bobofet2-1/mc68k-proto-board/README.md

# mc68k-proto-board
Code and design of legacy MC68000 proto board
