bobofet2-1/mc68k-proto-board/docs/design/initial/03-reset-halt.md

Complete MC68000 /HALT & /RESET Circuit — Full Pin Reference

--------------------------------------------------------------------------------------------------------------------------------------------------------------------------------------------------------------------

Component Pinouts Used

DS1813-5 (SOT-23, 3-pin)

   ┌──────┐
 1─┤GND   │
 2─┤VCC   │
 3─┤/RST  │  ← open-drain output
   └──────┘

74HC14 (DIP-14) — using gate 1 only

         ┌────┬────┐
    1A ──┤ 1  │ 14 ├── VCC
    1Y ──┤ 2  │  7 ├── GND
         │    │    │
   (2A ──┤ 3  │ 13 ├── 6A)  ← unused gates
   (2Y ──┤ 4  │ 12 ├── 6Y)
   (3A ──┤ 5  │ 11 ├── 5A)
   (3Y ──┤ 6  │ 10 ├── 5Y)
         └────┴────┘
           (7=GND, 8=4Y, 9=4A)

74HC07 (DIP-14) — using gate 1 only

         ┌────┬────┐
    1A ──┤ 1  │ 14 ├── VCC
    1Y ──┤ 2  │  7 ├── GND   ← open-drain output
         │    │    │
   (2A ──┤ 3  │ 13 ├── 6A)  ← unused gates, leave inputs tied to GND
   (2Y ──┤ 4  │ 12 ├── 6Y)
   (3A ──┤ 5  │ 11 ├── 5A)
   (3Y ──┤ 6  │ 10 ├── 5Y)
         └────┴────┘

MC68000 (DIP-64) — relevant pins only

   Pin 14 → VCC
   Pin 16 → GND
   Pin 17 → /HALT   (bidirectional open-drain)
   Pin 18 → /RESET  (bidirectional open-drain)

--------------------------------------------------------------------------------------------------------------------------------------------------------------------------------------------------------------------

Complete Schematic

 +5V ──────┬──────────────────────────────────────────────────────────────────────┐
           │                                                                       │
           ├──[R1 4.7kΩ]──────────────────────────────────── MC68000 pin 18 /RESET│
           │                                                         │             │
           ├──[R2 4.7kΩ]──────────────────────────────────── MC68000 pin 17 /HALT │
           │                                                         │             │
           │           ╔══ DS1813-5 ══╗                              │             │
           ├──────────►║ pin2  VCC    ║                              │             │
           │           ║              ║                              │             │
          GND ────────►║ pin1  GND    ║                              │             │
                       ║              ║                 RESET BUS    │             │
                       ║ pin3  /RST  ►╠════════════════════╦═════════╝             │
                       ╚══════════════╝                    ║                       │
                                                           ║                       │
           ╔══ 74HC07 ═══════╗                             ║                       │
 +5V ─────►║ pin14  VCC      ║                             ║                       │
 GND ─────►║ pin7   GND      ║                             ║                       │
           ║                 ║                             ║                       │
           ║ pin1   1A  ◄════╬══[see 74HC14 pin2 below]   ║                       │
           ║ pin2   1Y  ►════╬═══════════════════════════►╝                       │
           ║           (open-drain)                                                │
           ║ pin3,5,9,11 unused inputs → GND                                      │
           ╚═════════════════╝                                                     │
                                                                                   │
           ╔══ 74HC14 ═══════╗                                                     │
 +5V ─────►║ pin14  VCC      ║                                                     │
 GND ─────►║ pin7   GND      ║                                                     │
           ║                 ║                                                     │
   node A ►║ pin1   1A       ║                                                     │
           ║ pin2   1Y  ►════╬══► 74HC07 pin1 (1A)                                │
           ║                 ║                                                     │
           ║ pin3,5,9,11 unused inputs → GND                                      │
           ╚═════════════════╝                                                     │
                                                                                   │
           node A                                                                  │
           ┌──────┬──────────────────────────────────────────────────┐            │
           │      │                                                   │            │
      [R4 10kΩ]  [C2 1µF]                                          [SW1]         │
           │      │                                                   │            │
          +5V    GND                                                 GND           │
                                                                                   │
                                                                                   │
 +5V ──[R6 470Ω]──────[LED1 Blue ▶|]────────────────── MC68000 pin 17 /HALT ──────┘
                        anode   cathode

--------------------------------------------------------------------------------------------------------------------------------------------------------------------------------------------------------------------

Connection Summary Table

┌─────────────────────────┬──────────┬────────────────────┬─────┬────────────────────────────────┐
│ From                    │ Pin      │ To                 │ Pin │ Notes                          │
├─────────────────────────┼──────────┼────────────────────┼─────┼────────────────────────────────┤
│ +5V                     │ —        │ DS1813-5 VCC       │ 2   │                                │
├─────────────────────────┼──────────┼────────────────────┼─────┼────────────────────────────────┤
│ GND                     │ —        │ DS1813-5 GND       │ 1   │                                │
├─────────────────────────┼──────────┼────────────────────┼─────┼────────────────────────────────┤
│ DS1813-5 /RST           │ 3        │ RESET BUS          │ —   │ open-drain                     │
├─────────────────────────┼──────────┼────────────────────┼─────┼────────────────────────────────┤
│ +5V                     │ —        │ 74HC14 VCC         │ 14  │ 100nF bypass cap to GND        │
├─────────────────────────┼──────────┼────────────────────┼─────┼────────────────────────────────┤
│ GND                     │ —        │ 74HC14 GND         │ 7   │                                │
├─────────────────────────┼──────────┼────────────────────┼─────┼────────────────────────────────┤
│ Node A                  │ —        │ 74HC14 1A          │ 1   │ RC junction                    │
├─────────────────────────┼──────────┼────────────────────┼─────┼────────────────────────────────┤
│ 74HC14 1Y               │ 2        │ 74HC07 1A          │ 1   │ Schmitt output to buffer input │
├─────────────────────────┼──────────┼────────────────────┼─────┼────────────────────────────────┤
│ +5V                     │ —        │ 74HC07 VCC         │ 14  │ 100nF bypass cap to GND        │
├─────────────────────────┼──────────┼────────────────────┼─────┼────────────────────────────────┤
│ GND                     │ —        │ 74HC07 GND         │ 7   │                                │
├─────────────────────────┼──────────┼────────────────────┼─────┼────────────────────────────────┤
│ 74HC07 1Y               │ 2        │ RESET BUS          │ —   │ open-drain                     │
├─────────────────────────┼──────────┼────────────────────┼─────┼────────────────────────────────┤
│ +5V                     │ —        │ R1 (4.7kΩ) →       │ —   │ to RESET BUS / MC68000 pin 18  │
├─────────────────────────┼──────────┼────────────────────┼─────┼────────────────────────────────┤
│ +5V                     │ —        │ R2 (4.7kΩ) →       │ —   │ to MC68000 pin 17              │
├─────────────────────────┼──────────┼────────────────────┼─────┼────────────────────────────────┤
│ RESET BUS               │ —        │ MC68000 /RESET     │ 18  │ wire-OR                        │
├─────────────────────────┼──────────┼────────────────────┼─────┼────────────────────────────────┤
│ RESET BUS               │ —        │ MC68000 /HALT      │ 17  │ wire-OR                        │
├─────────────────────────┼──────────┼────────────────────┼─────┼────────────────────────────────┤
│ +5V                     │ —        │ R6 (470Ω) → LED1 → │ —   │ to MC68000 pin 17              │
├─────────────────────────┼──────────┼────────────────────┼─────┼────────────────────────────────┤
│ Node A                  │ —        │ R4 (10kΩ)          │ —   │ pull-up to +5V                 │
├─────────────────────────┼──────────┼────────────────────┼─────┼────────────────────────────────┤
│ Node A                  │ —        │ C2 (1µF)           │ —   │ to GND                         │
├─────────────────────────┼──────────┼────────────────────┼─────┼────────────────────────────────┤
│ Node A                  │ —        │ SW1                │ —   │ other end to GND               │
├─────────────────────────┼──────────┼────────────────────┼─────┼────────────────────────────────┤
│ 74HC14/07 unused inputs │ 3,5,9,11 │ GND                │ —   │ prevent floating               │
└─────────────────────────┴──────────┴────────────────────┴─────┴────────────────────────────────┘

--------------------------------------------------------------------------------------------------------------------------------------------------------------------------------------------------------------------

Bypass Capacitors (don't omit these)

┌─────────────────┬───────────────┬────────────────────────────┐
│ Component       │ Cap           │ Placement                  │
├─────────────────┼───────────────┼────────────────────────────┤
│ 74HC14 pin14/7  │ 100nF ceramic │ as close as possible to IC │
├─────────────────┼───────────────┼────────────────────────────┤
│ 74HC07 pin14/7  │ 100nF ceramic │ as close as possible to IC │
├─────────────────┼───────────────┼────────────────────────────┤
│ DS1813-5 pin2/1 │ 100nF ceramic │ across VCC/GND             │
└─────────────────┴───────────────┴────────────────────────────┘
