bobofet2-1/mc68k-proto-board/docs/design/initial/04-reset-halt.md

MC68000 /HALT \& /RESET Circuit — Complete With Pin Numbers

\---

ASCII Schematic

&#x20;                                                                    MC68000

+5V ──┬──\[R3 10kΩ]──────┬──────────────────────────────────────────────────
│                  │
│            DS1813-5                           74HC07 (DIP-14)
│            ┌─────┴──┐                        ┌──────────────────┐
├──────────► │2  VCC  │              ┌─────────┤1(1A)    (1Y)2├───────────┐
│            │        │              │    ┌────┤3(2A)    (2Y)4├────────┐  │
GND ────────► │1  GND  │              │    │    │                  │    │  │
│        │              │    │    │  +5V ──────────► │14  │  │
│3  /RST ├──────────────┘    │    │  GND ──────────► │7   │  │
└────────┘  (open-drain)      │    │                  │    │  │
│    │    ┌─────────────┤5(3A) │  │
│    │    │    ┌────────┤9(4A) │  │
│    │    │    │        │         │  │
│    │    │    │    (3Y)6├───────────┤
│    │    │    │    (4Y)8├────────┤  │
│    │    │    │         │        │  │
│    │    │    │  unused:│        │  │
│    │    │    │  11,13 ─► GND    │  │
│    │    │    │         └─────────┘  │
│    │    │    │                      │
74HC14 (DIP-14)                            │    │    │    │                      │
┌───────────────┐                          │    │    │    │                      │
│               │                          │    │    │    │                      │
│ (1A)1 ◄── NODE\_A                         │    │    │    │                      │
│ (1Y)2 ─────────────────────────────────────────────────┘                      │
│                │                                  │                            │
│  +5V ────────► │14                                │                            │
│  GND ────────► │7                                 │                            │
│                │                                  │  /RESET node               │
│  3,5,9,11 ──► GND (unused inputs)                 │                            │
└────────────────┘                                  │                            │
│   R1 4.7kΩ                 │
+5V ───┴──\[R1]──────────── MC68000 pin 18 /RESET
│
└── (gates 1+3 open-drain outputs)

NODE\_A ──\[R4 10kΩ]── +5V
NODE\_A ──\[C2 1µF] ── GND
NODE\_A ──\[SW1]────── GND

&#x20;                    /HALT node

+5V ──\[R2 4.7kΩ]──────────────────────────── MC68000 pin 17 /HALT
│
├── 74HC07 pin4  (gate 2 output, open-drain)
└── 74HC07 pin8  (gate 4 output, open-drain)

+5V ──\[R6 470Ω]──\[Blue LED ▶|]────────────── MC68000 pin 17 /HALT

\---

Clean Connection Table

DS1813-5

┌─────┬──────┬──────────────────────────────────────────────┐
│ Pin │ Name │ Connects to                                  │
├─────┼──────┼──────────────────────────────────────────────┤
│ 1   │ GND  │ GND                                          │
├─────┼──────┼──────────────────────────────────────────────┤
│ 2   │ VCC  │ +5V                                          │
├─────┼──────┼──────────────────────────────────────────────┤
│ 3   │ /RST │ R3 (10kΩ to +5V), 74HC07 pin 1, 74HC07 pin 3 │
└─────┴──────┴──────────────────────────────────────────────┘

74HC14 (gate 1 only)

┌──────────┬───────────────┬────────────────────────────┐
│ Pin      │ Name          │ Connects to                │
├──────────┼───────────────┼────────────────────────────┤
│ 1        │ 1A            │ NODE\_A (RC junction)       │
├──────────┼───────────────┼────────────────────────────┤
│ 2        │ 1Y            │ 74HC07 pin 5, 74HC07 pin 9 │
├──────────┼───────────────┼────────────────────────────┤
│ 3,5,9,11 │ unused inputs │ GND                        │
├──────────┼───────────────┼────────────────────────────┤
│ 7        │ GND           │ GND                        │
├──────────┼───────────────┼────────────────────────────┤
│ 14       │ VCC           │ +5V                        │
└──────────┴───────────────┴────────────────────────────┘

74HC07 (gates 1–4)

┌─────┬──────┬──────────────┬─────────────────────────┐
│ Pin │ Name │ Connects to  │ Purpose                 │
├─────┼──────┼──────────────┼─────────────────────────┤
│ 1   │ 1A   │ DS1813 pin 3 │ power-on reset → /RESET │
├─────┼──────┼──────────────┼─────────────────────────┤
│ 2   │ 1Y   │ /RESET node  │ open-drain              │
├─────┼──────┼──────────────┼─────────────────────────┤
│ 3   │ 2A   │ DS1813 pin 3 │ power-on reset → /HALT  │
├─────┼──────┼──────────────┼─────────────────────────┤
│ 4   │ 2Y   │ /HALT node   │ open-drain              │
├─────┼──────┼──────────────┼─────────────────────────┤
│ 5   │ 3A   │ 74HC14 pin 2 │ switch reset → /RESET   │
├─────┼──────┼──────────────┼─────────────────────────┤
│ 6   │ 3Y   │ /RESET node  │ open-drain              │
├─────┼──────┼──────────────┼─────────────────────────┤
│ 7   │ GND  │ GND          │                         │
├─────┼──────┼──────────────┼─────────────────────────┤
│ 8   │ 4Y   │ /HALT node   │ open-drain              │
├─────┼──────┼──────────────┼─────────────────────────┤
│ 9   │ 4A   │ 74HC14 pin 2 │ switch reset → /HALT    │
├─────┼──────┼──────────────┼─────────────────────────┤
│ 10  │ 5Y   │ —            │ unused                  │
├─────┼──────┼──────────────┼─────────────────────────┤
│ 11  │ 5A   │ GND          │ tie unused input        │
├─────┼──────┼──────────────┼─────────────────────────┤
│ 12  │ 6Y   │ —            │ unused                  │
├─────┼──────┼──────────────┼─────────────────────────┤
│ 13  │ 6A   │ GND          │ tie unused input        │
├─────┼──────┼──────────────┼─────────────────────────┤
│ 14  │ VCC  │ +5V          │                         │
└─────┴──────┴──────────────┴─────────────────────────┘

/RESET Node (MC68000 pin 18)

┌──────────────┬──────────────────────────┐
│ Connection   │ Value                    │
├──────────────┼──────────────────────────┤
│ Pull-up R1   │ 4.7kΩ to +5V             │
├──────────────┼──────────────────────────┤
│ 74HC07 pin 2 │ gate 1 open-drain output │
├──────────────┼──────────────────────────┤
│ 74HC07 pin 6 │ gate 3 open-drain output │
└──────────────┴──────────────────────────┘

/HALT Node (MC68000 pin 17)

┌────────────────────┬────────────────────────────────────┐
│ Connection         │ Value                              │
├────────────────────┼────────────────────────────────────┤
│ Pull-up R2         │ 4.7kΩ to +5V                       │
├────────────────────┼────────────────────────────────────┤
│ 74HC07 pin 4       │ gate 2 open-drain output           │
├────────────────────┼────────────────────────────────────┤
│ 74HC07 pin 8       │ gate 4 open-drain output           │
├────────────────────┼────────────────────────────────────┤
│ R6 470Ω → Blue LED │ anode to +5V, cathode to this node │
└────────────────────┴────────────────────────────────────┘

Debounce (NODE\_A)

┌──────────────┬─────────────────────────┐
│ Connection   │ Value                   │
├──────────────┼─────────────────────────┤
│ R4           │ 10kΩ to +5V             │
├──────────────┼─────────────────────────┤
│ C2           │ 1µF to GND              │
├──────────────┼─────────────────────────┤
│ SW1          │ momentary button to GND │
├──────────────┼─────────────────────────┤
│ 74HC14 pin 1 │ Schmitt trigger input   │
└──────────────┴─────────────────────────┘

\---

Bill of Materials

┌──────────┬─────────────┬────────────────────────────────────┐
│ Ref      │ Part        │ Value                              │
├──────────┼─────────────┼────────────────────────────────────┤
│ R1, R2   │ Resistor    │ 4.7kΩ                              │
├──────────┼─────────────┼────────────────────────────────────┤
│ R3       │ Resistor    │ 10kΩ (DS1813 output pull-up)       │
├──────────┼─────────────┼────────────────────────────────────┤
│ R4       │ Resistor    │ 10kΩ (switch pull-up)              │
├──────────┼─────────────┼────────────────────────────────────┤
│ R6       │ Resistor    │ 470Ω (LED)                         │
├──────────┼─────────────┼────────────────────────────────────┤
│ C2       │ Capacitor   │ 1µF (debounce)                     │
├──────────┼─────────────┼────────────────────────────────────┤
│ C3,C4,C5 │ Capacitor   │ 100nF ceramic (bypass, one per IC) │
├──────────┼─────────────┼────────────────────────────────────┤
│ U1       │ 74HC14      │ DIP-14 Schmitt inverter            │
├──────────┼─────────────┼────────────────────────────────────┤
│ U2       │ 74HC07      │ DIP-14 open-drain buffer           │
├──────────┼─────────────┼────────────────────────────────────┤
│ U3       │ DS1813-5    │ SOT-23 supervisor                  │
├──────────┼─────────────┼────────────────────────────────────┤
│ SW1      │ Push button │ SPST-NO momentary                  │
├──────────┼─────────────┼────────────────────────────────────┤
│ LED1     │ Blue LED    │ Vf \~3.2V                           │
└──────────┴─────────────┴────────────────────────────────────┘
