bobofet2-1/mc68k-proto-board/MC68000.docx

MC68000 / DIP-64 Inner Overlay (chip top, names only)

VPA VCC

E GND

VMA D15

IPL2 D14

IPL1 D13

IPL0 D12

FC2 D11

FC1 D10

FC0 D9

A23 D8

A22 D7

A21 D6

A20 D5

A19 D4

A18 D3

A17 D2

A16 D1

A15 D0

A14 R/W

A13 AS

A12 LDS

A11 UDS

A10 DTACK

A9 BG

A8 BGACK

A7 BR

A6 HALT

A5 RESET

A4 BERR

A3 A1

A2 NC

A1 GND
