bobofet2-1/mc68k-proto-board/docs/Background/MC68000_HALT_RESET_Circuit.pdf

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

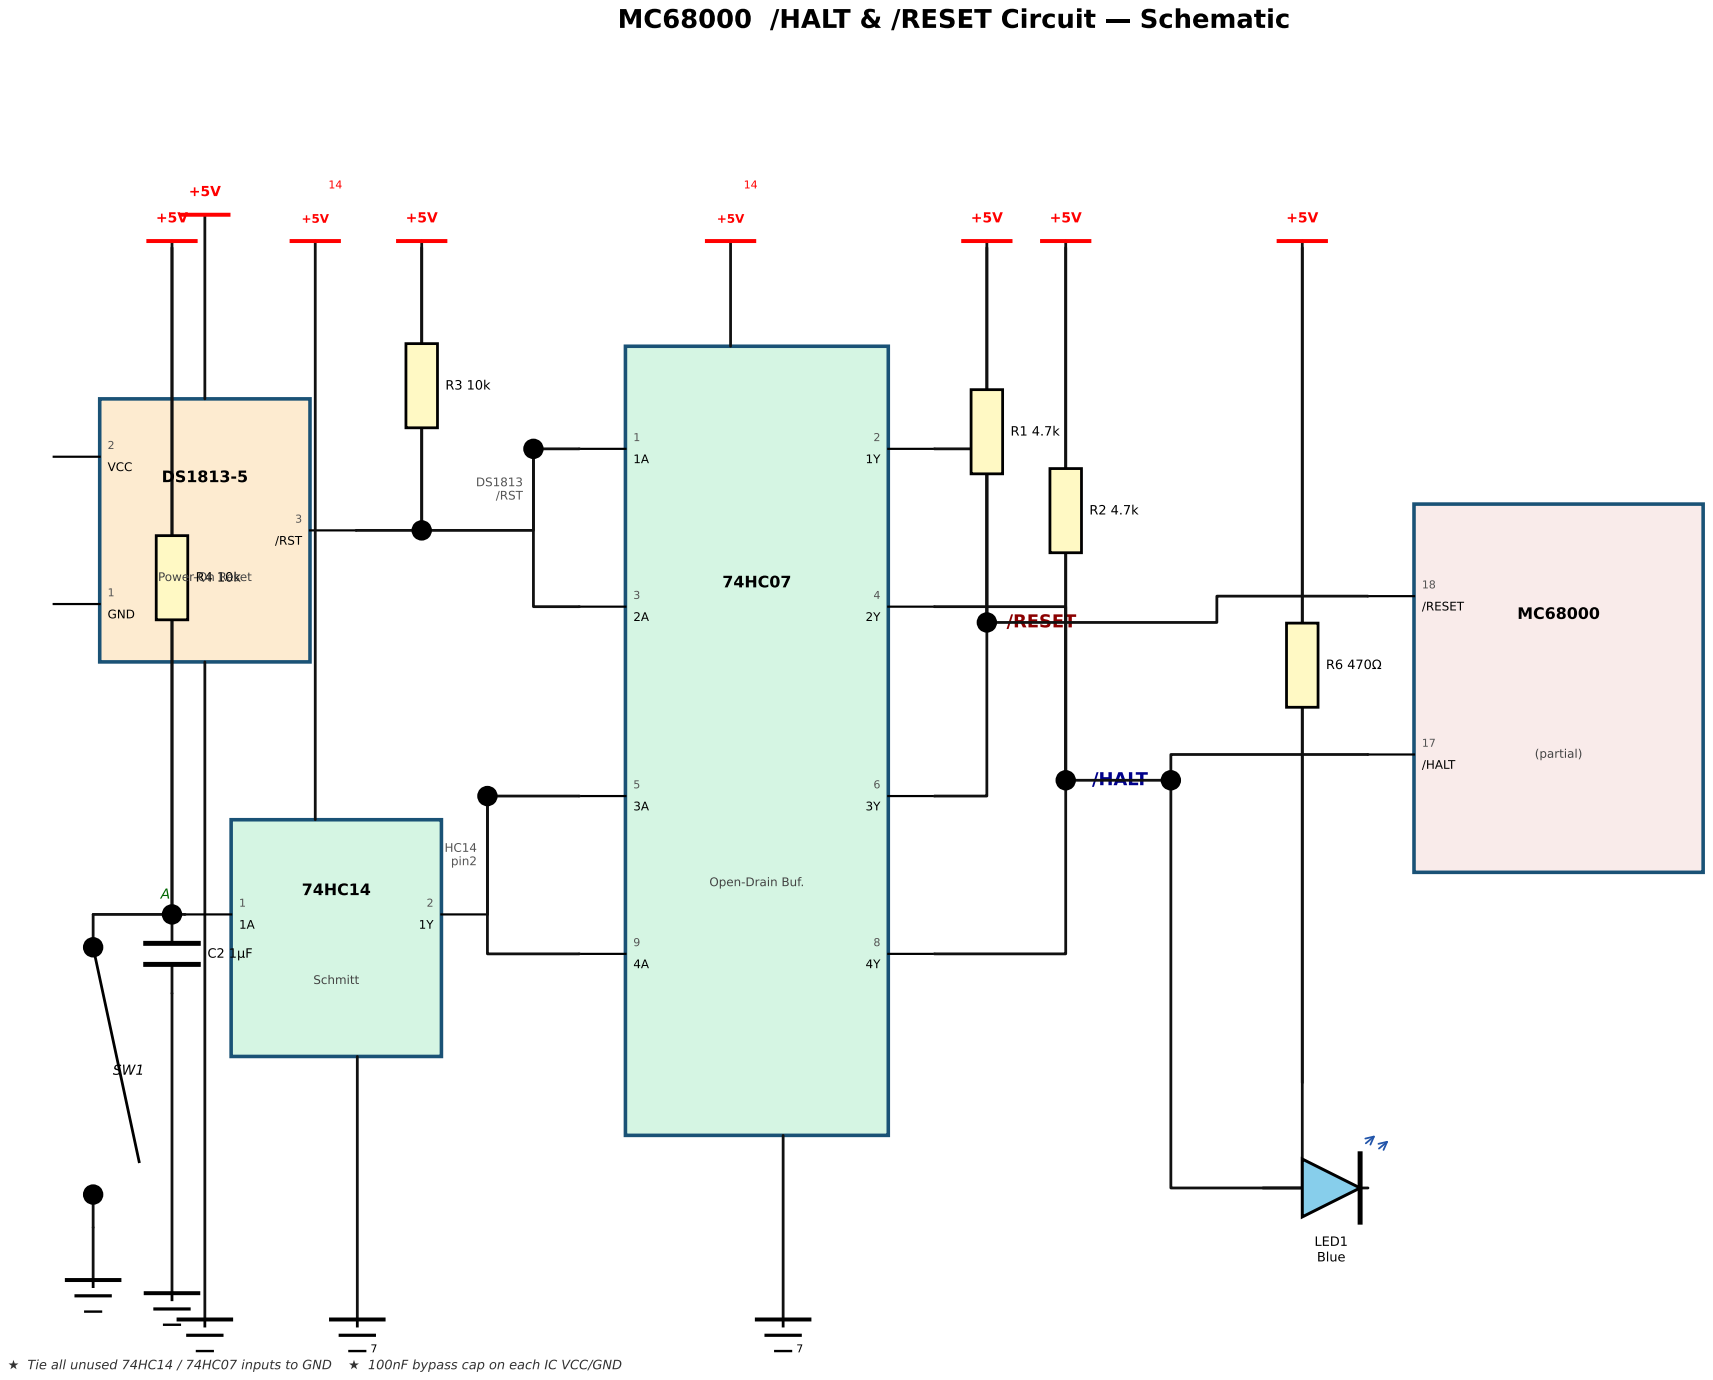
[picture p1: page 1]

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

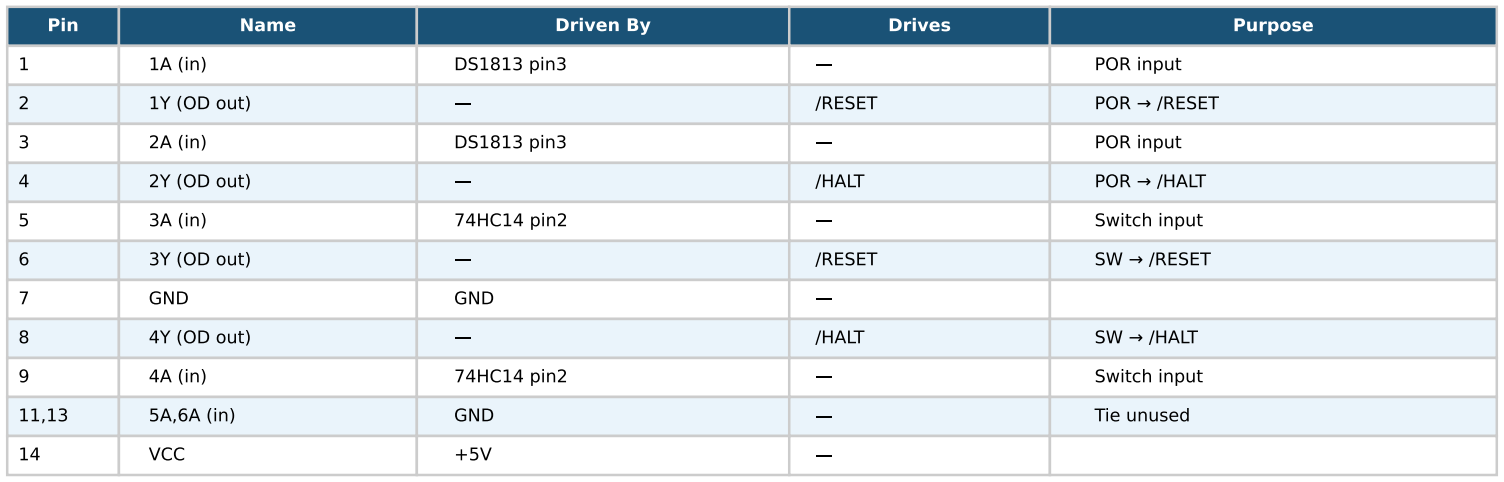
[picture p2: figure]
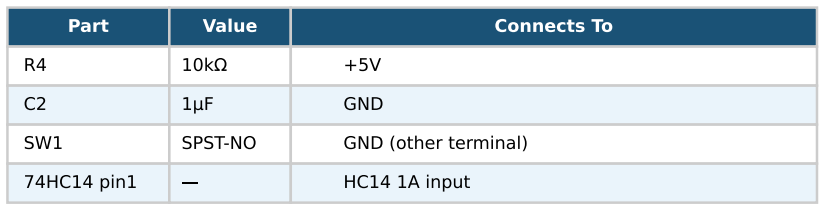
[picture p3: figure]

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

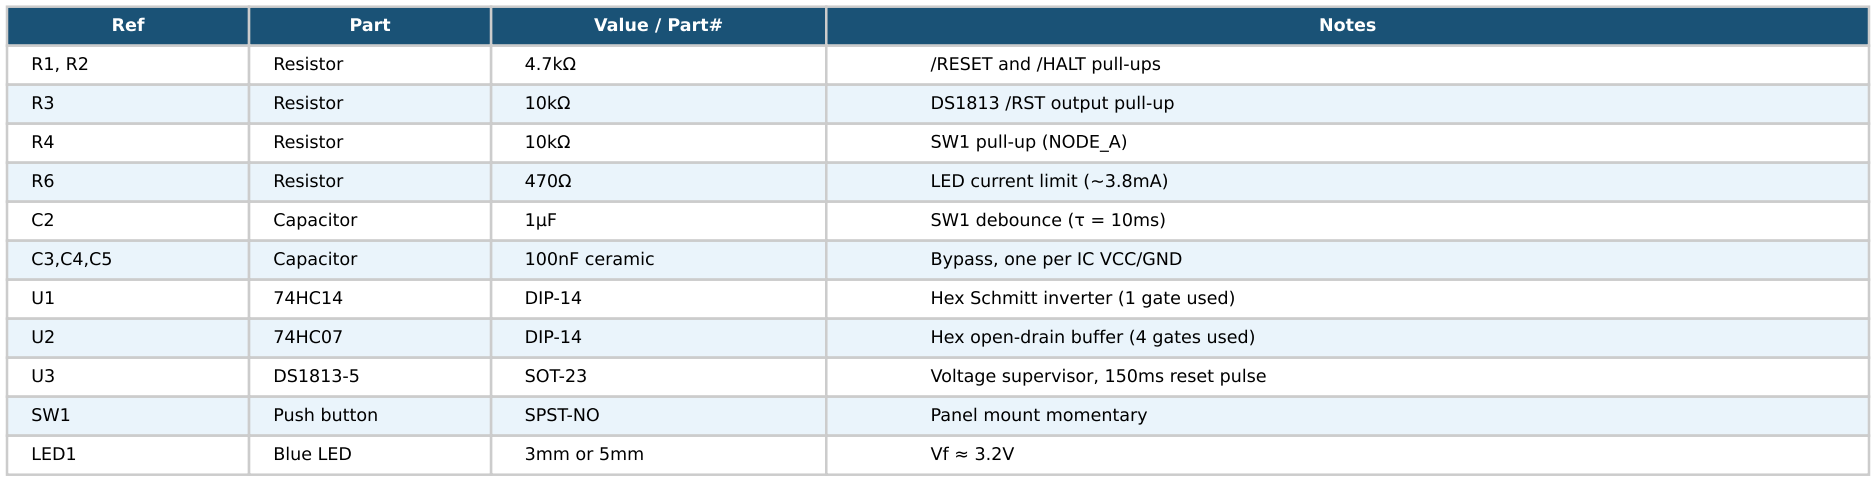
[picture p4: figure]
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
