bobofet2-1/mc68k-proto-board/docs/Background/01- adr-decode-mc68000.png

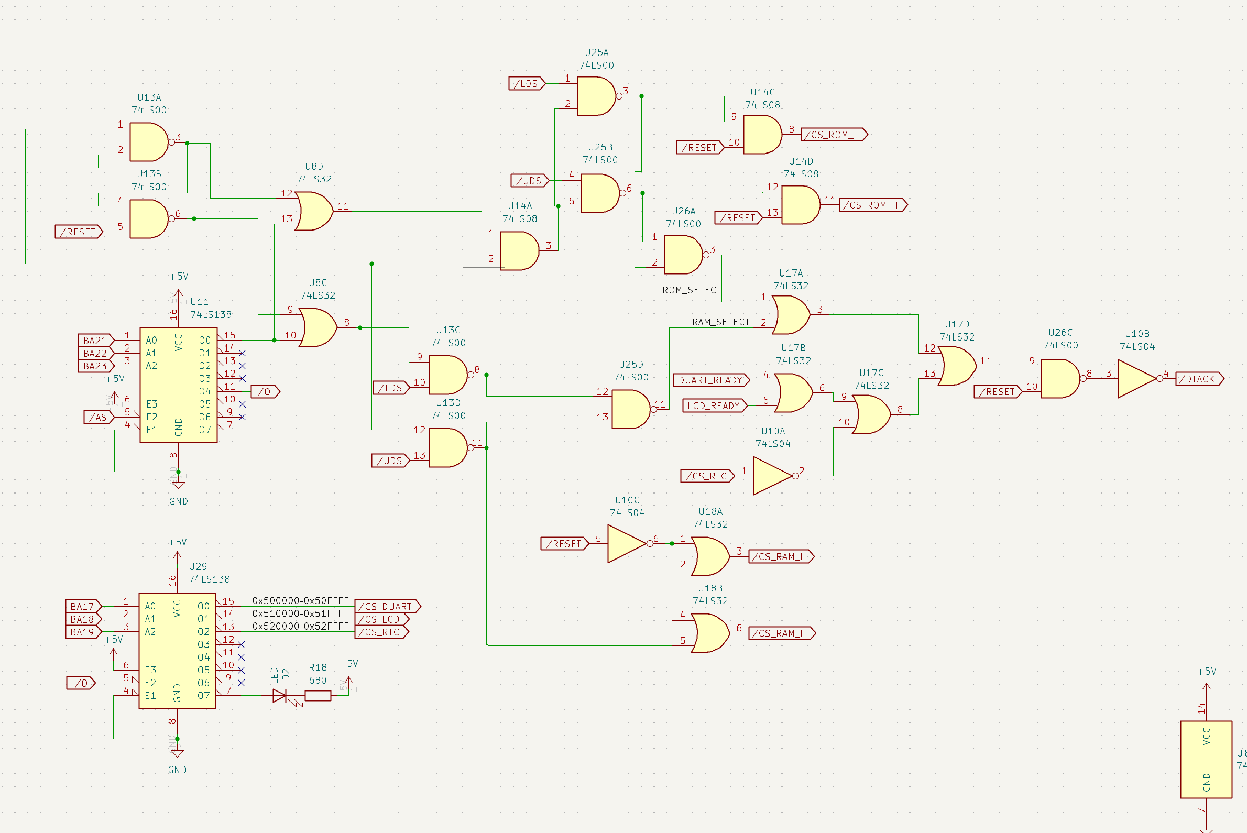
docs/Background/01- adr-decode-mc68000.png
