bobofet2-1/mc68k-proto-board/docs/Background/adr-decode68000.png

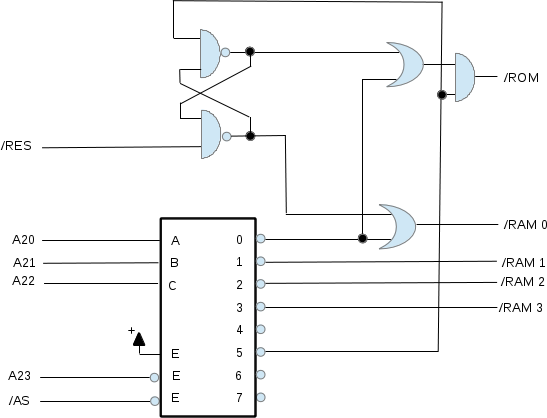
docs/Background/adr-decode68000.png
