bobofet2-1/mc68k-proto-board/hardware/downloaded libraries/DS1813-5/DS1813-5.step

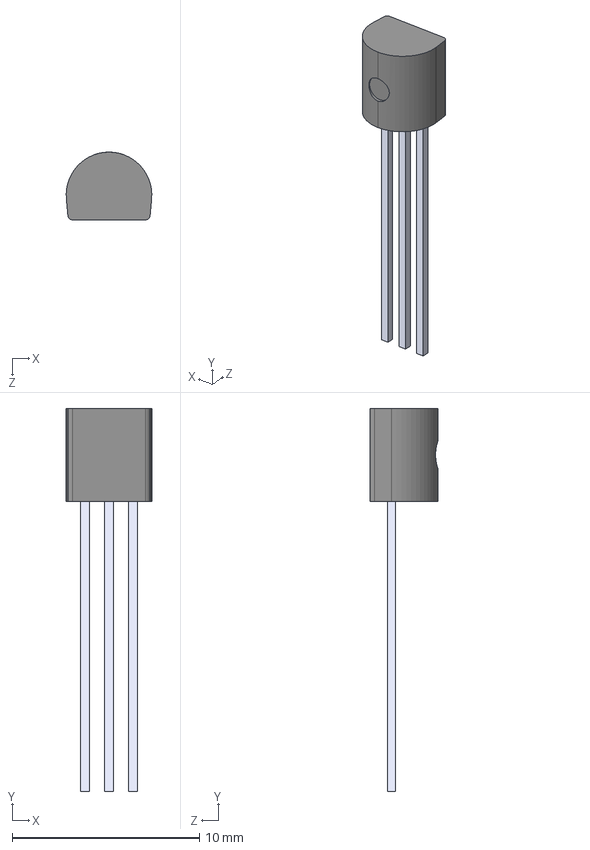
[picture p7: CAD file, 2026-07-12]
hardware/downloaded libraries/DS1813-5/DS1813-5.step
4.57 x 20.4 x 3.62 mm
