bobofet2-1/mc68k-proto-board/hardware/MC68000-v5/MC68000-first.pdf

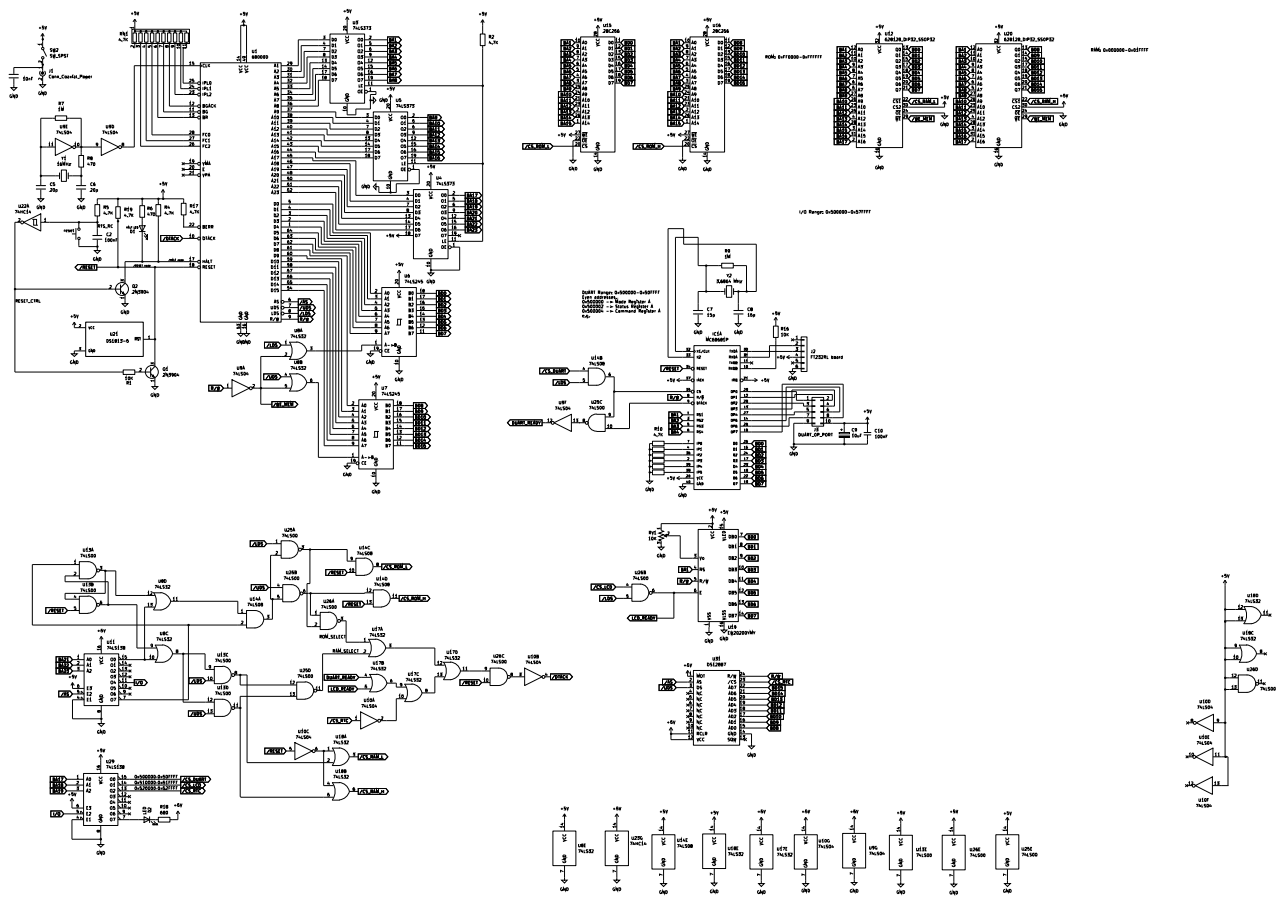
[picture p8: page 1]
