bobofet2-1/mc68k-proto-board/(list of files, drawings)

Other design files:
hardware/MC68000-v5/MC68000.dsn
hardware/previous_versions/MC68000-v3/MC68000.dsn
hardware/previous_versions/MC68000/MC68000.dsn
