bobofet2-1/mc68k-proto-board/hardware/MC68000-v5/MC68000.kicad_pcb

## KiCad design hardware/MC68000-v5/MC68000.kicad_pcb (2026-07-12)

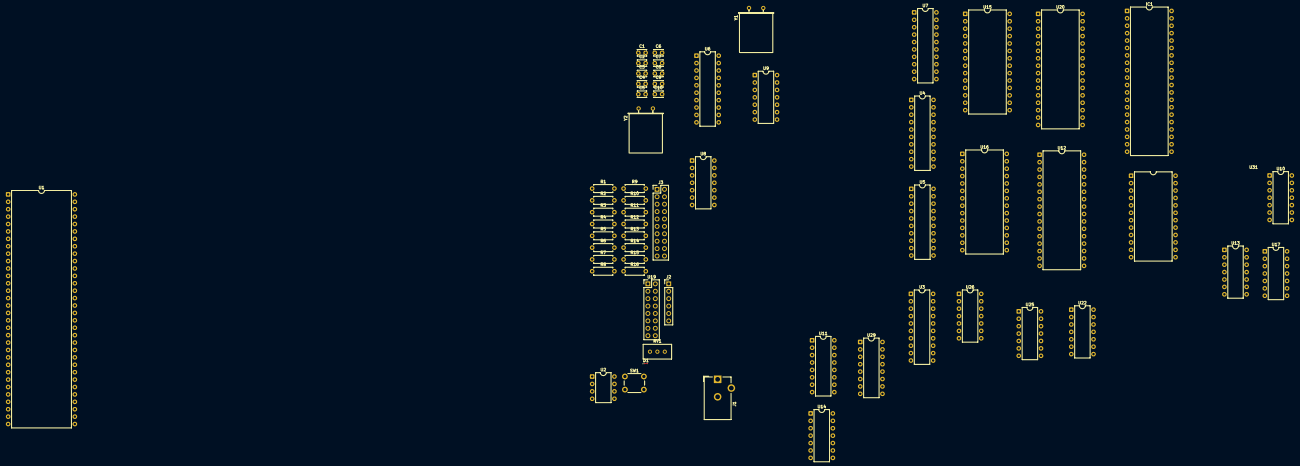
[picture p9: board MC68000.kicad_pcb from above]

Board: 2 copper layers, 59 parts (0 on the bottom side), 146 nets, no tracks yet.

Parts:
C1: 10nF; C_Disc_D3.0mm_W2.0mm_P2.50mm
C2: 100n; C_Disc_D3.0mm_W2.0mm_P2.50mm
C3: 10n; C_Disc_D3.0mm_W2.0mm_P2.50mm
C4: 1u; C_Disc_D3.0mm_W2.0mm_P2.50mm
C5, C6, C7, C8: 15p; C_Disc_D3.0mm_W2.0mm_P2.50mm
C9: 10uF; C_Disc_D3.0mm_W2.0mm_P2.50mm
C10: 100nF; C_Disc_D3.0mm_W2.0mm_P2.50mm
D1: LED; LED_0201_0603Metric_Pad0.64x0.40mm_HandSolder
IC1: MC68681P; DIP-40_W15.24mm
J1: Conn_Coaxial_Power; BarrelJack_CUI_PJ-102AH_Horizontal
J2: FT232RL board; PinHeader_1x06_P2.54mm_Vertical
J3: DUART_OP_PORT; PinHeader_2x10_P2.54mm_Vertical
R1, R7, R9: 1M; R_Axial_DIN0207_L6.3mm_D2.5mm_P7.62mm_Horizontal
R2, R3, R4, R10, R11, R12, R13, R14, R15: 4.7K; R_Axial_DIN0207_L6.3mm_D2.5mm_P7.62mm_Horizontal
R5, R8: 470; R_Axial_DIN0207_L6.3mm_D2.5mm_P7.62mm_Horizontal
R6: 220; R_Axial_DIN0207_L6.3mm_D2.5mm_P7.62mm_Horizontal
R16: 10K; R_Axial_DIN0207_L6.3mm_D2.5mm_P7.62mm_Horizontal
RV1: 10K; Potentiometer_Bourns_3296W_Vertical
SW1: reset; SW_PUSH_6mm
U1: 68000D; DIP-64_W22.86mm
U2: LM555xN; DIP-8_W7.62mm
U3, U4, U5: 74LS373; DIP-20_W7.62mm
U6, U7: 74LS245; DIP-20_W7.62mm
U8, U17: 74LS32; DIP-14_W7.62mm
U9, U10: 74LS04; DIP-14_W7.62mm
U11, U29: 74LS138; DIP-16_W7.62mm
U12, U20: 628128_DIP32_SSOP32; DIP-32_W15.24mm
U13, U25, U26: 74LS00; DIP-14_W7.62mm
U14: 74LS08; DIP-14_W7.62mm
U15, U16: 28C256; DIP-28_W15.24mm
U19: EW20200YMY; PinHeader_2x08_P2.54mm_Vertical
U22: 74LS05; DIP-14_W7.62mm
U31: DS12887; DIP-24_W15.24mm
Y1: 16MHz; Crystal_HC49-U_Horizontal
Y2: 3.6864 MHz; Crystal_HC49-U_Horizontal

Connections:
+5V: C1.2, C9.1, C10.1, D1.2 (A), IC1.20 (VCC), IC1.21 (IRQ), IC1.37 (IACK), J1.1 (In), J2.4, J3.10, R1.1, R2.1, R3.1, R4.1, R5.1, R16.1, RV1.1, U1.14 (VCC), U1.49 (VCC), U2.4 (R), U2.8 (VCC), U3.20 (VCC), U4.18 (D7), U4.20 (VCC), U5.20 (VCC), U6.20 (VCC), U7.20 (VCC), U8.14 (VCC), U9.14 (VCC), U10.3, U10.5, U10.9, U10.11, U10.13, U10.14 (VCC), U11.6 (E3), U11.16 (VCC), U12.30 (CS2), U12.32 (VCC), U13.14 (VCC), U14.9, U14.10, U14.12, U14.13, U14.14 (VCC), U15.27 (~WE), U15.28 (VCC), U16.27 (~WE), U16.28 (VCC), U17.14 (VCC), U19.2 (VCC), U19.15 (VLED), U20.30 (CS2), U20.32 (VCC), U22.3, U22.5, U22.9, U22.11, U22.13, U22.14 (VCC), U25.14 (VCC), U26.9, U26.10, U26.12, U26.13, U26.14 (VCC), U29.6 (E3), U29.16 (VCC), U31.1 (MOT), U31.11 (RCLR), U31.12 (VCC)
/RAM_SELECT: U17.2, U25.11
/ROM_SELECT: U17.1, U26.3
BA1: IC1.1 (RS1), U3.2 (O0), U12.12 (A0), U15.10 (A0), U16.10 (A0), U19.4 (RS), U20.12 (A0)
BA2: IC1.3 (RS2), U3.5 (O1), U12.11 (A1), U15.9 (A1), U16.9 (A1), U20.11 (A1)
BA3: IC1.5 (RS3), U3.6 (O2), U12.10 (A2), U15.8 (A2), U16.8 (A2), U20.10 (A2)
BA4: IC1.6 (RS4), U3.9 (O3), U12.9 (A3), U15.7 (A3), U16.7 (A3), U20.9 (A3)
BA5: U3.12 (O4), U12.8 (A4), U15.6 (A4), U16.6 (A4), U20.8 (A4)
BA6: U3.15 (O5), U12.7 (A5), U15.5 (A5), U16.5 (A5), U20.7 (A5)
BA7: U3.16 (O6), U12.6 (A6), U15.4 (A6), U16.4 (A6), U20.6 (A6)
BA8: U3.19 (O7), U12.5 (A7), U15.3 (A7), U16.3 (A7), U20.5 (A7)
BA9: U5.2 (O0), U12.27 (A8), U15.25 (A8), U16.25 (A8), U20.27 (A8)
BA10: U5.5 (O1), U12.26 (A9), U15.24 (A9), U16.24 (A9), U20.26 (A9)
BA11: U5.6 (O2), U12.23 (A10), U15.21 (A10), U16.21 (A10), U20.23 (A10)
BA12: U5.9 (O3), U12.25 (A11), U15.23 (A11), U16.23 (A11), U20.25 (A11)
BA13: U5.12 (O4), U12.4 (A12), U15.2 (A12), U16.2 (A12), U20.4 (A12)
BA14: U5.15 (O5), U12.28 (A13), U15.26 (A13), U16.26 (A13), U20.28 (A13)
BA15: U5.16 (O6), U12.3 (A14), U15.1 (A14), U16.1 (A14), U20.3 (A14)
BA16: U5.19 (O7), U12.31 (A15), U20.31 (A15)
BA17: U4.2 (O0), U12.2 (A16), U20.2 (A16), U29.1 (A0)
BA18: U4.5 (O1), U29.2 (A1)
BA19: U4.6 (O2), U29.3 (A2)
BA21: U4.12 (O4), U11.1 (A0)
BA22: U4.15 (O5), U11.2 (A1)
BA23: U4.16 (O6), U11.3 (A2)
BD0: IC1.25 (D0), U6.18 (B0), U12.13 (Q0), U15.11 (D0)
BD1: IC1.16 (D1), U6.17 (B1), U12.14 (Q1), U15.12 (D1), U19.8 (DB1)
BD2: IC1.24 (D2), U6.16 (B2), U12.15 (Q2), U15.13 (D2), U19.9 (DB2)
BD3: IC1.17 (D3), U6.15 (B3), U12.17 (Q3), U15.15 (D3), U19.10 (DB3)
BD4: IC1.23 (D4), U6.14 (B4), U12.18 (Q4), U15.16 (D4), U19.11 (DB4)
BD5: IC1.18 (D5), U6.13 (B5), U12.19 (Q5), U15.17 (D5), U19.12 (DB5)
BD6: IC1.22 (D6), U6.12 (B6), U12.20 (Q6), U15.18 (D6), U19.13 (DB6)
BD7: IC1.19 (D7), U6.11 (B7), U12.21 (Q7), U15.19 (D7), U19.14 (DB7)
BD8: U7.18 (B0), U16.11 (D0), U20.13 (Q0), U31.15 (AD0)
BD9: U7.17 (B1), U16.12 (D1), U20.14 (Q1), U31.16 (AD1)
BD10: U7.16 (B2), U16.13 (D2), U20.15 (Q2), U31.17 (AD2)
BD11: U7.15 (B3), U16.15 (D3), U20.17 (Q3), U31.18 (AD3)
BD12: U7.14 (B4), U16.16 (D4), U20.18 (Q4), U31.19 (AD4)
BD13: U7.13 (B5), U16.17 (D5), U20.19 (Q5), U31.20 (AD5)
BD14: U7.12 (B6), U16.18 (D6), U20.20 (Q6), U31.21 (AD6)
BD15: U7.11 (B7), U16.19 (D7), U20.21 (Q7), U31.22 (AD7)
DUART_READY: U9.12, U17.4
GND: C1.1, C2.2, C3.2, C4.1, C4.2, C5.2, C6.2, C7.2, C8.2, C9.2, C10.2, IC1.40 (GND), J1.2 (Ext), J2.6, J3.9, R5.2, R10.1, R11.1, R12.1, R13.1, R14.1, R15.1, RV1.3, SW1.1, U1.16 (GND), U1.53 (GND), U2.1 (GND), U2.6 (THR), U2.7 (DIS), U3.1 (OE), U3.10 (GND), U4.1 (OE), U4.10 (GND), U5.1 (OE), U5.10 (GND), U6.10 (GND), U6.19 (CE), U7.10 (GND), U7.19 (CE), U8.7 (GND), U9.7 (GND), U10.7 (GND), U11.4 (E1), U11.8 (GND), U12.16 (GND), U12.24 (~OE), U13.7 (GND), U14.7 (GND), U15.14 (GND), U15.22 (~OE), U16.14 (GND), U16.22 (~OE), U17.7 (GND), U19.16 (VLSS), U20.16 (GND), U20.24 (~OE), U22.7 (GND), U25.7 (GND), U26.7 (GND), U29.4 (E1), U29.8 (GND), U31.14 (GND)
I/O: U11.11 (O4), U29.5 (E2)
LCD_READY: U17.5, U19.6 (E), U26.6
unnamed: C5.1, R7.1, U9.11, Y1.1
unnamed: C6.1, R8.2, Y1.2
unnamed: D1.1 (K), R6.1
unnamed: IC1.35 (CS), U14.6, U25.9
unnamed: IC1.9 (DTACK), U25.10
unnamed: IC1.7 (IP0), R10.2
unnamed: IC1.4 (IP1), R11.2
unnamed: IC1.36 (IP2), R12.2
unnamed: IC1.2 (IP3), R13.2
unnamed: IC1.39 (IP4), R14.2
unnamed: IC1.38 (IP5), R15.2
unnamed: IC1.29 (OP0), J3.1
unnamed: IC1.12 (OP1), J3.2
unnamed: IC1.28 (OP2), J3.3
unnamed: IC1.13 (OP3), J3.4
unnamed: IC1.27 (OP4), J3.5
unnamed: IC1.14 (OP5), J3.6
unnamed: IC1.26 (OP6), J3.7
unnamed: IC1.15 (OP7), J3.8
unnamed: IC1.31 (RXDA), J2.2
unnamed: IC1.10 (RXDB), R16.2
unnamed: IC1.30 (TXDA), J2.3
unnamed: C7.1, IC1.32 (X1/CLK), R9.1, Y2.1
unnamed: C8.1, IC1.33 (X2), R9.2, Y2.2
unnamed: R6.2, U22.2
unnamed: R7.2, R8.1, U9.9, U9.10
unnamed: U1.29 (A1), U3.3 (D0)
unnamed: U1.30 (A2), U3.4 (D1)
unnamed: U1.31 (A3), U3.7 (D2)
unnamed: U1.32 (A4), U3.8 (D3)
unnamed: U1.33 (A5), U3.13 (D4)
unnamed: U1.34 (A6), U3.14 (D5)
unnamed: U1.35 (A7), U3.17 (D6)
unnamed: U1.36 (A8), U3.18 (D7)
unnamed: U1.37 (A9), U5.3 (D0)
unnamed: U1.38 (A10), U5.4 (D1)
unnamed: U1.39 (A11), U5.7 (D2)
unnamed: U1.40 (A12), U5.8 (D3)
unnamed: U1.41 (A13), U5.13 (D4)
unnamed: U1.42 (A14), U5.14 (D5)
unnamed: U1.43 (A15), U5.17 (D6)
unnamed: U1.44 (A16), U5.18 (D7)
unnamed: U1.45 (A17), U4.3 (D0)
unnamed: U1.46 (A18), U4.4 (D1)
unnamed: U1.47 (A19), U4.7 (D2)
unnamed: U1.48 (A20), U4.8 (D3)
unnamed: U1.50 (A21), U4.13 (D4)
unnamed: U1.51 (A22), U4.14 (D5)
unnamed: U1.52 (A23), U4.17 (D6)
unnamed: U1.15 (CLK), U9.8
unnamed: U1.5 (D0), U6.2 (A0)
unnamed: U1.4 (D1), U6.3 (A1)
unnamed: U1.3 (D2), U6.4 (A2)
unnamed: U1.2 (D3), U6.5 (A3)
unnamed: U1.1 (D4), U6.6 (A4)
unnamed: U1.64 (D5), U6.7 (A5)
unnamed: U1.63 (D6), U6.8 (A6)
unnamed: U1.62 (D7), U6.9 (A7)
unnamed: U1.61 (D8), U7.2 (A0)
unnamed: U1.60 (D9), U7.3 (A1)
unnamed: U1.59 (D10), U7.4 (A2)
unnamed: U1.58 (D11), U7.5 (A3)
unnamed: U1.57 (D12), U7.6 (A4)
unnamed: U1.56 (D13), U7.7 (A5)
unnamed: U1.55 (D14), U7.8 (A6)
unnamed: U1.54 (D15), U7.9 (A7)
unnamed: R3.2, U1.17 (HALT), U9.4, U22.1
unnamed: C3.1, U2.5 (CV)
unnamed: U2.3 (Q), U9.3, U9.5
unnamed: C2.1, R1.2, SW1.2, U2.2 (TR)
unnamed: R2.2, U3.11 (LE), U4.11 (LE), U5.11 (LE)
unnamed: U6.1 (A->B), U8.3
unnamed: U7.1 (A->B), U8.6
unnamed: U8.2, U8.5, U9.2
unnamed: U10.2, U17.10
unnamed: U8.10, U8.13, U11.15 (O0)
unnamed: U11.7 (O7), U13.1, U14.2
unnamed: U8.9, U13.2, U13.6
unnamed: U8.12, U13.3, U13.4
unnamed: U8.8, U13.9, U13.12
unnamed: U8.11, U14.1
unnamed: U14.3, U25.2, U25.5
unnamed: U17.6, U17.9
unnamed: U17.3, U17.12
unnamed: U17.8, U17.13
unnamed: RV1.2, U19.3 (Vo)
unnamed: U9.13, U25.8
R/W: IC1.8 (R/~W), U1.9 (R/W), U9.1, U19.5 (R/W), U31.24 (R/W)
/AS: U1.6 (AS), U11.5 (E2), U31.2 (AS)
/CS_DUART: U14.4, U29.15 (O0)
/CS_LCD: U26.4, U29.14 (O1)
/CS_RAM_H: U13.11, U20.22 (~CS1), U25.13
/CS_RAM_L: U12.22 (~CS1), U13.8, U25.12
/CS_ROM_H: U16.20 (~CS), U25.6, U26.1
/CS_ROM_L: U15.20 (~CS), U25.3, U26.2
/CS_RTC: U10.1, U29.13 (O2), U31.23 (/CS)
/DTACK: U1.10 (DTACK), U17.11
/LDS: U1.8 (LDS), U8.1, U13.10, U14.5, U25.1, U26.5
/RESET: IC1.34 (RESET), R4.2, U1.18 (RESET), U9.6, U13.5
/UDS: U1.7 (UDS), U8.4, U13.13, U25.4, U31.3 (DS)
/WE_MEM: U12.29 (~WE), U20.29 (~WE)
