bobofet2-1/mc68k-proto-board/hardware/downloaded libraries/MC68681P/MC68000-2.kicad_sch

## KiCad design hardware/downloaded libraries/MC68681P/MC68000-2.kicad_sch (2026-07-12)

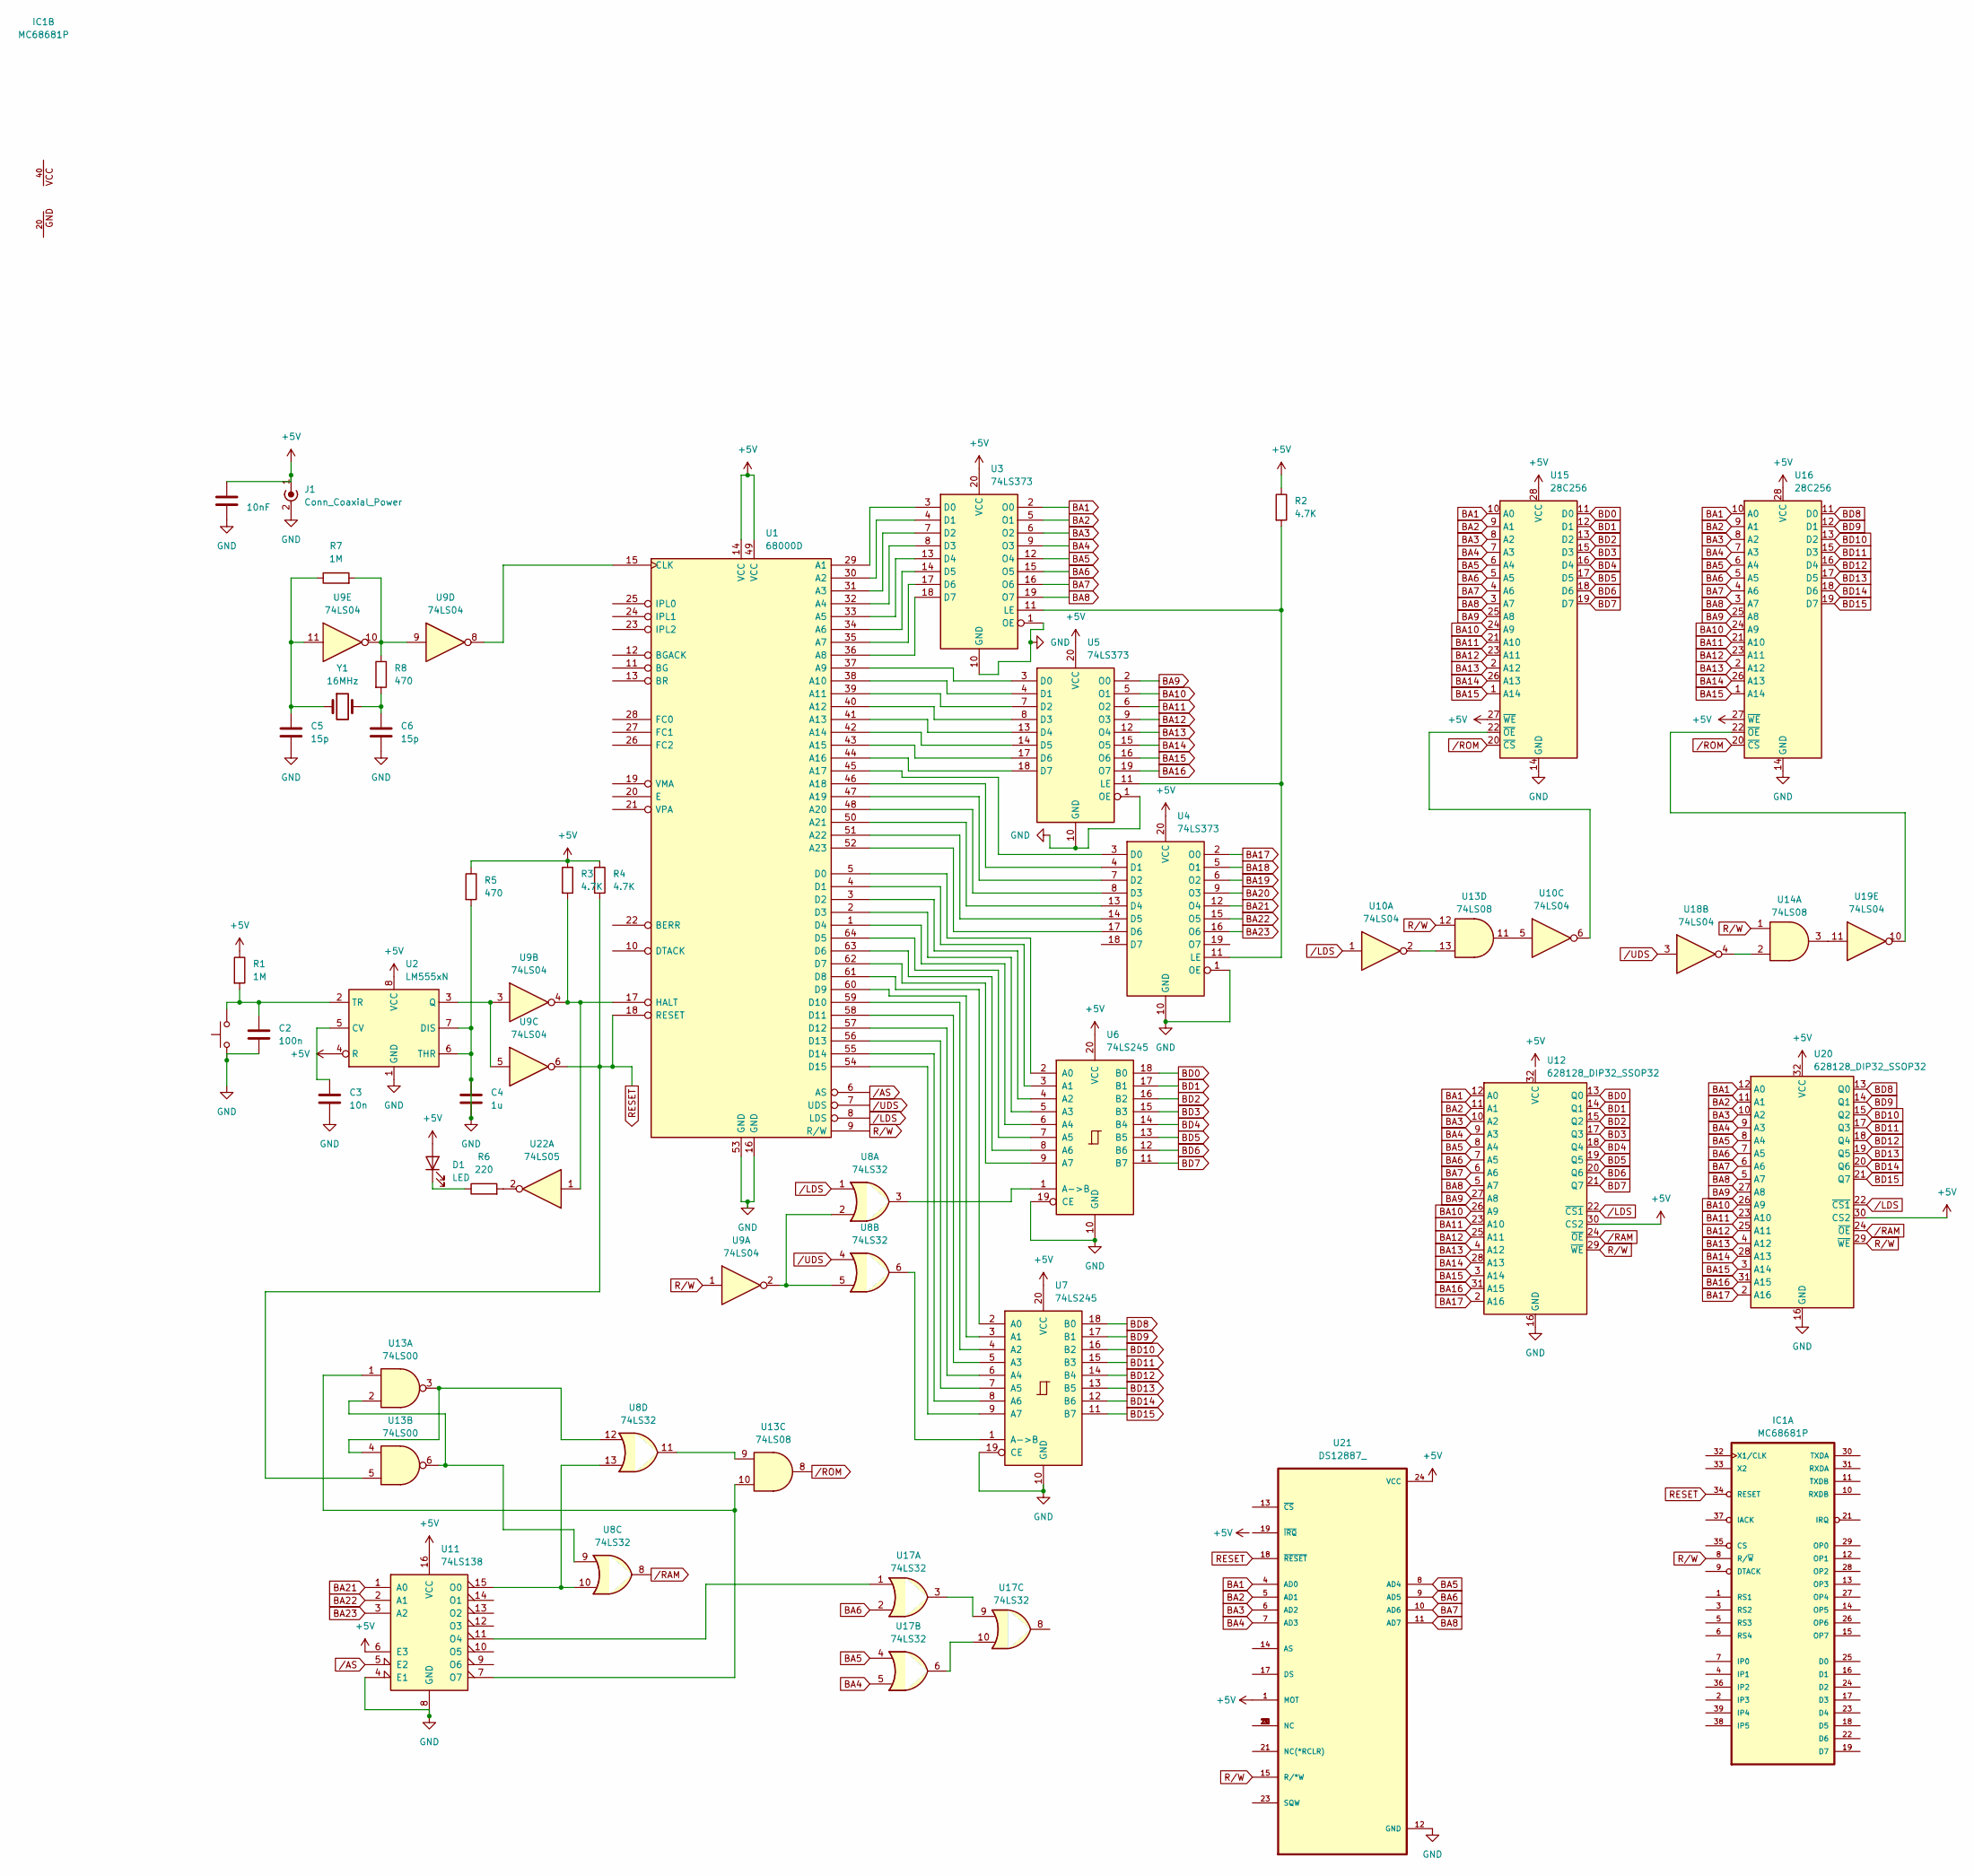
[picture p10: schematic MC68000-2.kicad_sch]

Parts:
C1: 10nF
C2: 100n
C3: 10n
C4: 1u
C5, C6: 15p
D1: LED
IC1: MC68681P; DIL40
J1: Conn_Coaxial_Power
R1, R7: 1M
R2, R3, R4: 4.7K
R5, R8: 470
R6: 220
SW1: (no value)
U1: 68000D
U2: LM555xN; DIP-8_W7.62mm
U3, U4, U5: 74LS373
U6, U7: 74LS245
U8, U17: 74LS32
U9, U10, U18, U19: 74LS04
U11: 74LS138
U12, U20: 628128_DIP32_SSOP32
U13: 74LS00
U14: 74LS08
U15, U16: 28C256
U21: DS12887_; DIP1549W45P254L3404H940Q24
U22: 74LS05
Y1: 16MHz

Connections:
+5V: C1.2, D1.2 (A), J1.1 (In), R1.1, R2.1, R3.1, R4.1, R5.1, U1.14 (VCC), U1.49 (VCC), U2.4 (R), U2.8 (VCC), U3.20 (VCC), U4.20 (VCC), U5.20 (VCC), U6.20 (VCC), U7.20 (VCC), U11.6 (E3), U11.16 (VCC), U12.30 (CS2), U15.27 (~WE), U15.28 (VCC), U16.27 (~WE), U16.28 (VCC), U20.30 (CS2), U20.32 (VCC), U21.1 (MOT), U21.24 (VCC)
BA1: U3.2 (O0), U12.12 (A0), U15.10 (A0), U16.10 (A0), U20.12 (A0), U21.4 (AD0)
BA2: U3.5 (O1), U12.11 (A1), U15.9 (A1), U16.9 (A1), U20.11 (A1), U21.5 (AD1)
BA3: U3.6 (O2), U12.10 (A2), U15.8 (A2), U16.8 (A2), U20.10 (A2), U21.6 (AD2)
BA4: U3.9 (O3), U12.9 (A3), U15.7 (A3), U16.7 (A3), U17.5, U20.9 (A3), U21.7 (AD3)
BA5: U3.12 (O4), U12.8 (A4), U15.6 (A4), U16.6 (A4), U17.4, U20.8 (A4), U21.8 (AD4)
BA6: U3.15 (O5), U12.7 (A5), U15.5 (A5), U16.5 (A5), U17.2, U20.7 (A5), U21.9 (AD5)
BA7: U3.16 (O6), U12.6 (A6), U15.4 (A6), U16.4 (A6), U20.6 (A6), U21.10 (AD6)
BA8: U3.19 (O7), U12.5 (A7), U15.3 (A7), U16.3 (A7), U20.5 (A7), U21.11 (AD7)
BA9: U5.2 (O0), U12.27 (A8), U15.25 (A8), U16.25 (A8), U20.27 (A8)
BA10: U5.5 (O1), U12.26 (A9), U15.24 (A9), U16.24 (A9), U20.26 (A9)
BA11: U5.6 (O2), U12.23 (A10), U15.21 (A10), U16.21 (A10), U20.23 (A10)
BA12: U5.9 (O3), U12.25 (A11), U15.23 (A11), U16.23 (A11), U20.25 (A11)
BA13: U5.12 (O4), U12.4 (A12), U15.2 (A12), U16.2 (A12), U20.4 (A12)
BA14: U5.15 (O5), U12.28 (A13), U15.26 (A13), U16.26 (A13), U20.28 (A13)
BA15: U5.16 (O6), U12.3 (A14), U15.1 (A14), U16.1 (A14), U20.3 (A14)
BA16: U5.19 (O7), U12.31 (A15), U20.31 (A15)
BA17: U4.2 (O0), U12.2 (A16), U20.2 (A16)
BA18: U4.5 (O1)
BA19: U4.6 (O2)
BA20: U4.9 (O3)
BA21: U4.12 (O4), U11.1 (A0)
BA22: U4.15 (O5), U11.2 (A1)
BA23: U4.16 (O6), U11.3 (A2)
BD0: U6.18 (B0), U12.13 (Q0), U15.11 (D0)
BD1: U6.17 (B1), U12.14 (Q1), U15.12 (D1)
BD2: U6.16 (B2), U12.15 (Q2), U15.13 (D2)
BD3: U6.15 (B3), U12.17 (Q3), U15.15 (D3)
BD4: U6.14 (B4), U12.18 (Q4), U15.16 (D4)
BD5: U6.13 (B5), U12.19 (Q5), U15.17 (D5)
BD6: U6.12 (B6), U12.20 (Q6), U15.18 (D6)
BD7: U6.11 (B7), U12.21 (Q7), U15.19 (D7)
BD8: U7.18 (B0), U16.11 (D0), U20.13 (Q0)
BD9: U7.17 (B1), U16.12 (D1), U20.14 (Q1)
BD10: U7.16 (B2), U16.13 (D2), U20.15 (Q2)
BD11: U7.15 (B3), U16.15 (D3), U20.17 (Q3)
BD12: U7.14 (B4), U16.16 (D4), U20.18 (Q4)
BD13: U7.13 (B5), U16.17 (D5), U20.19 (Q5)
BD14: U7.12 (B6), U16.18 (D6), U20.20 (Q6)
BD15: U7.11 (B7), U16.19 (D7), U20.21 (Q7)
GND: C1.1, C2.2, C3.2, C4.1, C4.2, C5.2, C6.2, J1.2 (Ext), R5.2, SW1.1 (A), SW1.2 (A), U1.16 (GND), U1.53 (GND), U2.1 (GND), U2.6 (THR), U2.7 (DIS), U3.1 (OE), U3.10 (GND), U4.1 (OE), U4.10 (GND), U5.1 (OE), U5.10 (GND), U6.10 (GND), U6.19 (CE), U7.10 (GND), U7.19 (CE), U11.4 (E1), U11.8 (GND), U12.16 (GND), U15.14 (GND), U16.14 (GND), U20.16 (GND), U21.12 (GND)
unnamed: C2.1, R1.2, SW1.3 (B), SW1.4 (B), U2.2 (TR)
unnamed: C3.1, U2.5 (CV)
unnamed: C5.1, R7.1, U9.11, Y1.1
unnamed: C6.1, R8.2, Y1.2
unnamed: D1.1 (K), R6.1
unnamed: R2.2, U3.11 (LE), U4.11 (LE), U5.11 (LE)
unnamed: R3.2, U1.17 (HALT), U9.4, U22.1
unnamed: R6.2, U22.2
unnamed: R7.2, R8.1, U9.9, U9.10
unnamed: U1.1 (D4), U6.6 (A4)
unnamed: U1.2 (D3), U6.5 (A3)
unnamed: U1.3 (D2), U6.4 (A2)
unnamed: U1.4 (D1), U6.3 (A1)
unnamed: U1.5 (D0), U6.2 (A0)
unnamed: U1.15 (CLK), U9.8
unnamed: U1.29 (A1), U3.3 (D0)
unnamed: U1.30 (A2), U3.4 (D1)
unnamed: U1.31 (A3), U3.7 (D2)
unnamed: U1.32 (A4), U3.8 (D3)
unnamed: U1.33 (A5), U3.13 (D4)
unnamed: U1.34 (A6), U3.14 (D5)
unnamed: U1.35 (A7), U3.17 (D6)
unnamed: U1.36 (A8), U3.18 (D7)
unnamed: U1.37 (A9), U5.3 (D0)
unnamed: U1.38 (A10), U5.4 (D1)
unnamed: U1.39 (A11), U5.7 (D2)
unnamed: U1.40 (A12), U5.8 (D3)
unnamed: U1.41 (A13), U5.13 (D4)
unnamed: U1.42 (A14), U5.14 (D5)
unnamed: U1.43 (A15), U5.17 (D6)
unnamed: U1.44 (A16), U5.18 (D7)
unnamed: U1.45 (A17), U4.3 (D0)
unnamed: U1.46 (A18), U4.4 (D1)
unnamed: U1.47 (A19), U4.7 (D2)
unnamed: U1.48 (A20), U4.8 (D3)
unnamed: U1.50 (A21), U4.13 (D4)
unnamed: U1.51 (A22), U4.14 (D5)
unnamed: U1.52 (A23), U4.17 (D6)
unnamed: U1.54 (D15), U7.9 (A7)
unnamed: U1.55 (D14), U7.8 (A6)
unnamed: U1.56 (D13), U7.7 (A5)
unnamed: U1.57 (D12), U7.6 (A4)
unnamed: U1.58 (D11), U7.5 (A3)
unnamed: U1.59 (D10), U7.4 (A2)
unnamed: U1.60 (D9), U7.3 (A1)
unnamed: U1.61 (D8), U7.2 (A0)
unnamed: U1.62 (D7), U6.9 (A7)
unnamed: U1.63 (D6), U6.8 (A6)
unnamed: U1.64 (D5), U6.7 (A5)
unnamed: U2.3 (Q), U9.3, U9.5
unnamed: U6.1 (A->B), U8.3
unnamed: U7.1 (A->B), U8.6
unnamed: U8.2, U8.5, U9.2
unnamed: U10.2, U13.13
unnamed: U10.5, U13.11
unnamed: U10.6, U15.22 (~OE)
unnamed: U11.7 (O7), U13.1, U13.10
unnamed: U11.11 (O4), U17.1
unnamed: U8.10, U8.13, U11.15 (O0)
unnamed: U8.9, U13.2, U13.6
unnamed: U8.12, U13.3, U13.4
unnamed: U8.11, U13.9
unnamed: U14.2, U18.4
unnamed: U14.3, U19.11
unnamed: U16.22 (~OE), U19.10
unnamed: U17.3, U17.9
unnamed: U17.6, U17.10
unnamed: U21.2 (NC), U21.3 (NC), U21.16 (NC), U21.20 (NC), U21.22 (NC)
RESET: IC1.34 (RESET), R4.2, U1.18 (RESET), U9.6, U13.5, U21.18 (~RESET)
R/W: IC1.8 (R/~W), U1.9 (R/W), U9.1, U12.29 (~WE), U13.12, U14.1, U20.29 (~WE), U21.15 (R/*W)
/AS: U1.6 (AS), U11.5 (E2)
/LDS: U1.8 (LDS), U8.1, U10.1, U12.22 (~CS1), U20.22 (~CS1)
/RAM: U8.8, U12.24 (~OE), U20.24 (~OE)
/ROM: U13.8, U15.20 (~CS), U16.20 (~CS)
/UDS: U1.7 (UDS), U8.4, U18.3
