bobofet2-1/mc68k-proto-board/(commit log)

2026-07-12 Initial import of MC68000 prototype board
    [DS1813-5.step, MC68000-2.kicad_sch, MC68000-first.kicad_pcb, MC68000.csv, MC68000.dsn, MC68000.kicad_pcb, MC68000.kicad_sch, MC68000.xlsx]
2026-09-20 version 5
    [MC68000-first.kicad_pcb, MC68000.csv, MC68000.dsn, MC68000.kicad_pcb, MC68000.kicad_sch, Spare_logic.kicad_sch, untitled.kicad_sch]
2026-09-20 minor change to v5 version
    [MC68000.kicad_sch]
2026-10-01 rewiring 1
    [MC68000.kicad_sch]
